mbrijbhushan/HV-amplifier/README.md

# HV-amplifier
High-Voltage amplifier design files (+/- 415V, 10 mA current limit, 400 kHz bandwidth)
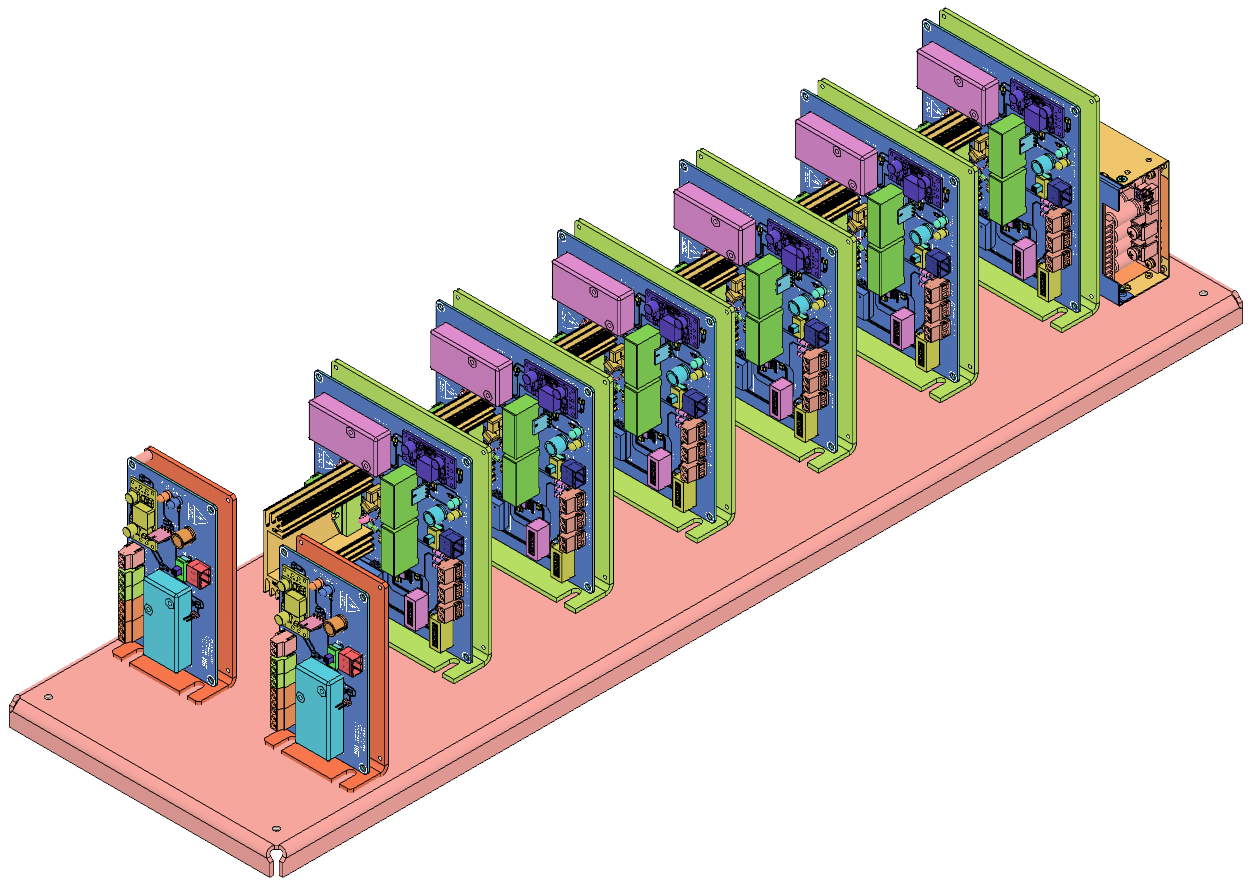
[picture p1: PCB_mounting/Amplifer__PCB_mount v39.png]
Amplifiers mounted on PCB mounts
