mbrijbhushan/HV-amplifier/HV_amplifier/CAD.png

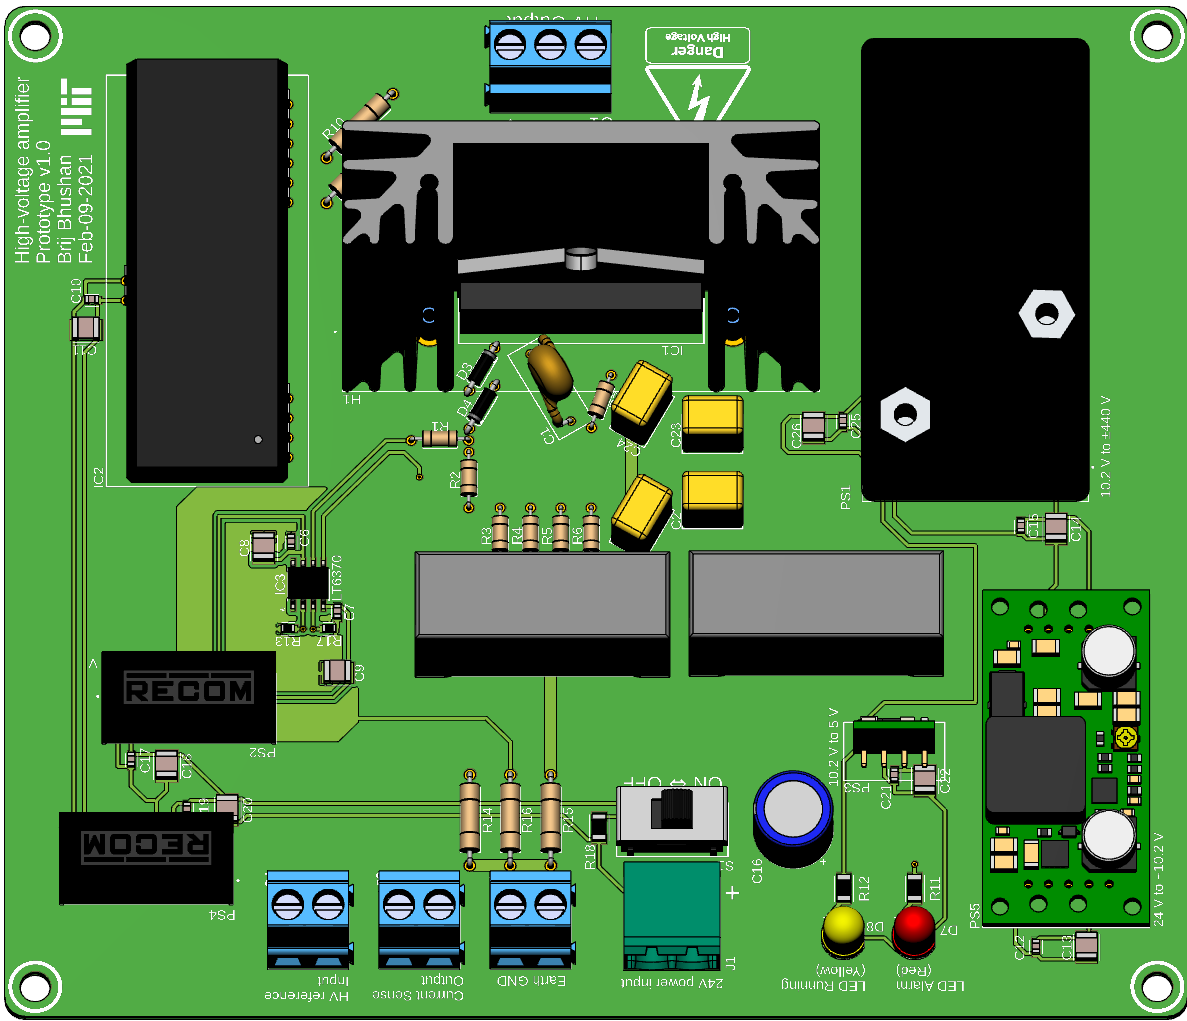
HV_amplifier/CAD.png
