mbrijbhushan/HV-amplifier/HV_powerSupply/CAD.png

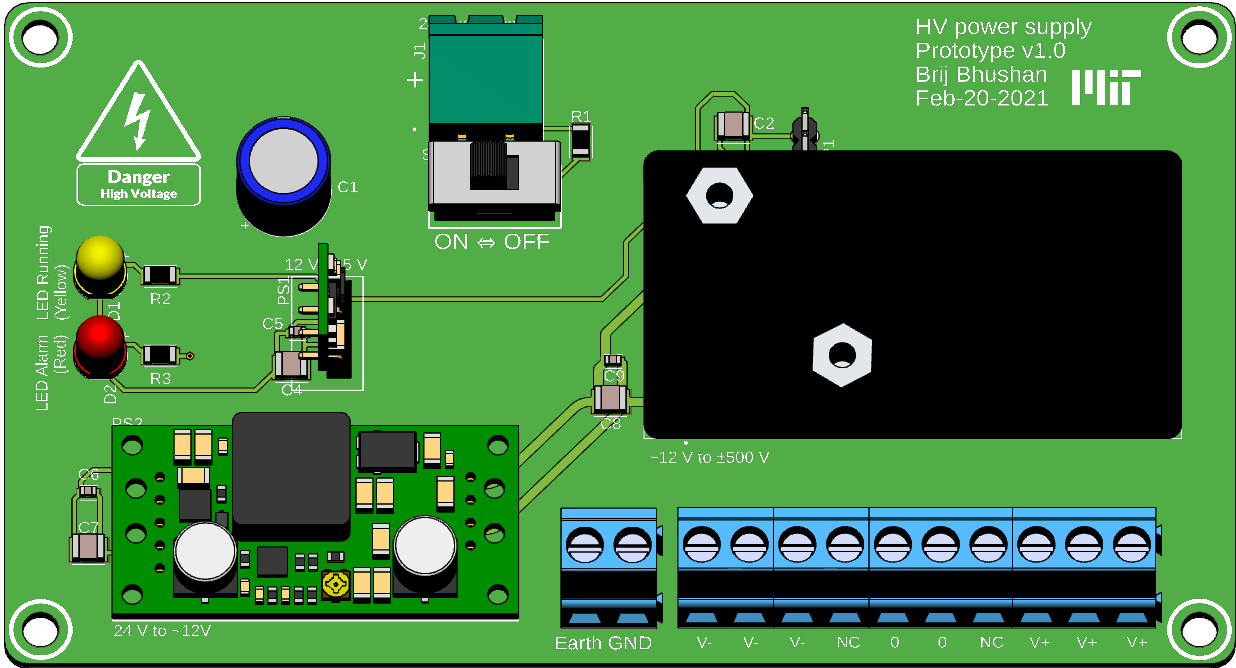
HV_powerSupply/CAD.png
