mbrijbhushan/HV-amplifier/BOM_list.xlsx

Sheet: Lin Amplifer (±440V)
#boards | 6 |  | $507.5366667 | (per ch.) |  | $3045.22 | (total)
Sch. Name | Part Number | Make | Cost per unit | # units per board | total # of units | Total cost | Vendor | Description
- | CUS600M-24/EF | TDK-Lambda | $190.00 | - | 1 | $190 | Digi-Key (https://www.digikey.com/product-detail/en/CUS600M-24%2fEF/285-CUS600M-24%2fEF-ND/12749522/?itemSeq=351333277) | 110VAC to 24VDC converter
C1 | 9004D7 | NTE Electronics, Inc | $0.20 | 1 | 6 | $1.2 | Digi-Key (https://www.digikey.com/product-detail/en/nte-electronics-inc/9004D7/2368-9004D7-ND/11648790) | Capacitor ceramic, 4.7pF, 1kV, radial, thru hole
C14 | CL32B226KAJNNNE | Samsung Electro-Mechanics | $0.60 | 1 | 6 | $3.6 | Digi-Key (https://www.digikey.com/en/products/detail/samsung-electro-mechanics/CL32B226KAJNNNE/3891478) | 22µF ±10% 25V Ceramic Capacitor X7R 1210 (3225 Metric)
C16 | A759MX447M1HAAE028 | Kemet | $3.00 | 2 | 12 | $36 | Digi-Key (https://www.digikey.com/en/products/detail/kemet/A759MX447M1HAAE028/6196518) | 440µF 50V Aluminum - Polymer Capacitors Radial, Can 28mOhm 2000 Hrs @ 125°C
C2 - C3 | C330C104KDR5TA | Kemet | $0.60 | 2 | 12 | $7.2 | Digi-Key (https://www.digikey.com/product-detail/en/kemet/C330C104KDR5TA/399-11994-ND/5267747) | Capacitor ceramic, 0.1uF, 1kV, X7R, radial, thru hole
C23 - C24 | CK45-B3AD102KYVNA | TDK Corporation | $0.40 | 2 | 12 | $4.8 | Digi-Key (https://www.digikey.com/en/products/detail/tdk-corporation/CK45-B3AD102KYVNA/8119816) | 1000pF ±10% 1000V (1kV) Ceramic Capacitor B Radial, Disc
C4 - C5 | C4AQSBU4100A1WJ | KEMET | $1.50 | 2 | 12 | $18 | Digi-Key (https://www.digikey.com/en/products/detail/kemet/C4AQSBU4100A1WJ/8345907) | 1µF Film Capacitor 1500V (1.5kV) Polypropylene (PP), Metallized Radial
C6,C7,C10,C12,C15,C17,C19,C21,C25 | CL10B104KB8NNWC | Samsung Electromechanics | $0.09 | 10 | 60 | $5.4 | Digi-Key (https://www.digikey.com/en/products/detail/samsung-electro-mechanics/CL10B104KB8NNWC/3890021) | 0.1µF ±10% 50V Ceramic Capacitor X7R 0603 (1608 Metric)
C8,C9,C11,C13,C18,C20,C22,C26 | CL32B106KBJNNNE | Samsung Electromechanics | $0.51 | 10 | 60 | $30.6 | Digi-Key (https://www.digikey.com/en/products/detail/samsung-electro-mechanics/CL32B106KBJNNNE/3891473) | 10µF ±10% 50V Ceramic Capacitor X7R 1210 (3225 Metric)
D1 - D2 | P6KE440A | Littlefuse Inc | $0.50 | 2 | 12 | $6 | Digi-Key (https://www.digikey.com/product-detail/en/littelfuse-inc/P6KE440A/P6KE440ALFCT-ND/1530656) | Transient Voltage Supression (Zener) diode, protect PA-95 power supplies from transients
D3 - D4 | 1N4148TR | Vishay | $0.06 | 2 | 12 | $0.72 | Digi-Key (https://www.digikey.com/product-detail/en/vishay-general-semiconductor-diodes-division/1N4148TR/1N4148VSCT-ND/3104297) | Small Signal Fast Switching Diodes, 4 ns recovery
D5 - D6 | NTE575 | NTE Electronics, Inc | $0.70 | 2 | 12 | $8.4 | Digi-Key (https://www.digikey.com/en/products/detail/nte-electronics-inc/NTE575/11647476) | Diode Standard 1000V 1A Through Hole DO-41
D7 | SSL-LX5093SID | Lumex Opto/Components Inc. | $0.50 | 1 | 6 | $3 | Digi-Key (https://www.digikey.com/en/products/detail/lumex-opto-components-inc/SSL-LX5093SID/519349) | Red LED Indication - Discrete 2V Radial
D8 | XLMYK65D | SunLED | $0.40 | 1 | 6 | $2.4 | Digi-Key (https://www.digikey.com/en/products/detail/sunled/XLMYK65D/13559343) | Yellow 590nm LED Indication - Discrete 2V Radial
IC3 | LT6370AHS8E#PBF | Analog Devices | $7.50 | 1 | 6 | $45 | Digi-Key (https://www.digikey.com/product-detail/en/analog-devices-inc/LT6370AHS8E-PBF/161-LT6370AHS8E-PBF-ND/10816302) | Instrumentation amplifier, used with G = -1
J1 | TBP01R1-508-02BE | CUI Devices | $0.50 | 1 | 6 | $3 | Digi-Key (https://www.digikey.com/en/products/detail/cui-devices/TBP01R1-508-02BE/10238383) | 2 Position Terminal Block Header, Male Pins, Shrouded (4 Side) 0.200" (5.08mm) 90°, Right Angle Through Hole
JG1 | TBP01P1-508-02BE | CUI Devices | $0.70 | 1 | 6 | $4.2 | Digi-Key (https://www.digikey.com/en/products/detail/cui-devices/TBP01P1-508-02BE/10238367) | 2 Position Terminal Block Plug, Female Sockets 0.200" (5.08mm) 180° Free Hanging (In-Line)
PS1 | FS10CT-12 | XP Power | $165.00 | 1 | 6 | $990 | Digi-Key (https://www.digikey.com/product-detail/en/FS10CT-12/1470-3291-ND/5873591/?itemSeq=351345335) | 12V DC to +/- 500 V DC converter
PS2 | RS-2415D | Recom Power | $14.00 | 1 | 6 | $84 | Digi-Key (https://www.digikey.com/product-detail/en/recom-power/RS-2415D/945-1316-ND/2256496) | 24 V to +/- 15 V DC-DC converter
PS4 | RS-2415S | Recom Power | $13.00 | 1 | 6 | $78 | Digi-Key (https://www.digikey.com/product-detail/en/recom-power/RS-2415S/945-1317-ND/2256497) | 24 V to 15 V DC-DC converter
R1 | MFP-25BRD52-12K | Yageo | $0.40 | 1 | 6 | $2.4 | Digi-Key (https://www.digikey.com/product-detail/en/yageo/MFP-25BRD52-12K/12KADCT-ND/2059116) | Resistor 12Kohm, 1/4W, 0.1% axial, Thru hole
R10 | CMF601K0000BHEB | Vishay Dale | $0.70 | 1 | 6 | $4.2 | Digi-Key (https://www.digikey.com/en/products/detail/vishay-dale/CMF601K0000BHEB/11561885) | 1 kOhms ±0.1% 1W Through Hole Resistor Axial Flame Retardant Coating, Moisture Resistant, Safety Metal Film
R11, R12 | RMCF1206JT240R | Stackpole Electronics Inc | $0.10 | 2 | 12 | $1.2 | Digi-Key (https://www.digikey.com/en/products/detail/stackpole-electronics-inc/RMCF1206JT240R/1942774) | 240 Ohms ±5% 0.25W, 1/4W Chip Resistor 1206 (3216 Metric) Automotive AEC-Q200 Thick Film
R13,R17 | ERA-3AEB104V | Panasonic Electronic Components | $0.30 | 2 | 12 | $3.6 | Digi-Key (https://www.digikey.com/en/products/detail/panasonic-electronic-components/ERA-3AEB104V/1466100) | 100 kOhms ±0.1% 0.1W, 1/10W Chip Resistor 0603 (1608 Metric) Automotive AEC-Q200 Thin Film
R14-R16 | ZR0207C | TE Connectivity Passive Product | $0.09 | 3 | 18 | $1.62 | Digi-Key (https://www.digikey.com/en/products/detail/te-connectivity-passive-product/ZR0207C/3477589) | 0 Ohms Jumper 0.25W, 1/4W Through Hole Resistor Axial Metal Foil
R18 | RPC1206JT1K00-UP | Stackpole Elec. Inc | $0.23 | 1 | 6 | $1.38 | Digi-Key (https://www.digikey.com/en/products/detail/stackpole-electronics-inc/RPC1206JT1K00-UP/10109084) | 1 kOhms ±5% 0.75W, 3/4W Chip Resistor 1206 (3216 Metric) Automotive AEC-Q200, Pulse Withstanding Thick Film
R19-R22 | ERT-J1VT202J | Panasonic Electronic Components | $0.15 | 4 | 24 | $3.6 | Digi-Key (https://www.digikey.com/en/products/detail/panasonic-electronic-components/ERT-J1VT202J/269345) | NTC Thermistor 2k 0603 (1608 Metric)
R2 - R6 | RNF14BTE100K | Stackpole Elec. Inc | $0.40 | 5 | 30 | $12 | Digi-Key (https://www.digikey.com/product-detail/en/stackpole-electronics-inc/RNF14BTE100K/RNF14BTE100KCT-ND/2022685) | Resistor 100Kohm, 1/4W, 0.1% axial, Thru hole
R7 | MFP-25BRD52-33R | Yageo | $0.40 | 1 | 6 | $2.4 | Digi-Key (https://www.digikey.com/product-detail/en/yageo/MFP-25BRD52-33R/33ADCT-ND/2059133) | Resistor 33ohm, 1/4W, 0.1% axial, Thru hole
R7* | MFP-25BRD52-75R | Yageo | $0.60 | 1 | 6 | $3.6 | Digi-Key (https://www.digikey.com/en/products/detail/yageo/MFP-25BRD52-75R/2059147) | 75 Ohms ±0.1% 0.25W, 1/4W Through Hole Resistor Axial Metal Film
R8 | CMF60100R00BHEB70 | Vishay Dale | $0.60 | 1 | 6 | $3.6 | Digi-Key (https://www.digikey.com/product-detail/en/vishay-dale/CMF60100R00BHEB70/541-CMF60100R00BHEB70CT-ND/11561982) | Resistor 100ohm, 1W, 0.1% axial, Thru hole
R9 | CMF559K0000BHBF | Vishay Dale | $0.70 | 1 | 6 | $4.2 | Digi-Key (https://www.digikey.com/en/products/detail/vishay-dale/CMF559K0000BHBF/3634478) | 9 kOhms ±0.1% 0.5W, 1/2W Through Hole Resistor Axial Flame Retardant Coating, Moisture Resistant, Safety Metal Film
S1 | CS12ANW03 | NKK Switches | $2.00 | 1 | 6 | $12 | Digi-Key (https://www.digikey.com/product-detail/en/nkk-switches/CS12ANW03/360-2131-ND/1014827) | SPDT slider switch for on/off
U1 | TB007-508-03BE | CUI Devices | $0.70 | 1 | 6 | $4.2 | Digi-Key (https://www.digikey.com/en/products/detail/cui-devices/TB007-508-03BE/10064128) | 3 Position Wire to Board Terminal Block Horizontal with Board 0.200" (5.08mm) Through Hole
U2-U4 | TB007-508-02BE | CUI Devices | $0.65 | 3 | 18 | $11.7 | Digi-Key (https://www.digikey.com/product-detail/en/cui-devices/TB007-508-02BE/102-6203-ND/10064127) | 2 Position Wire to Board Terminal Block Horizontal with Board 0.200" (5.08mm) Through Hole
PS3 | D24V5F5 | Pololu | $5.00 | 1 | 6 | $30 | Pololu (https://www.pololu.com/product/2843) | 5V, 500 mA step-down voltage regulator
PS5 | S18V20ALV | Pololu | $15.00 | 1 | 6 | $90 | Pololu (https://www.pololu.com/product/2572) | 4-12V step-up/step-down voltage regulator
H1 | HS 27 | Apex | $35.00 | 1 | 6 | $210 | TTL Electronics (https://ttlelectronics.net/shop/ols/products/hs27/v/HS27-1-9) | Heat-sink for linear power amplifiers
IC1 | PA 95 | Apex | $147.00 | 1 | 6 | $882 | TTL Electronics (https://ttlelectronics.net/shop/ols/products/pa95) | HV Linear power amplifiers
W1 | TW 13 | Apex | $10.00 | 1 | 6 | $60 | TTL Electronics (https://ttlelectronics.net/shop/ols/products/tw13) | Thermal Washer, SIP, 10 per pkg (for PA95)
IC2 | AD210BN | Analog Devices | $30.00 | 1 | 6 | $180 | UtSource (https://www.utsource.net/itm/p/1701914.html) | Isolation amplifier to sense the current
 |  |  |  |  |  | $0
 |  |  |  |  |  | $0

Sheet: Const. Volt (±440V)
#boards | 2 |  | $205.85 | (per ch.) | $411.7 | (total)
Sch. Name | Part Number | Make | Cost per unit | # units per board | total # of units | Total cost | Vendor | Description
- | CUS600M-24/EF | TDK-Lambda | $190.00 | 0 | 0 | $0 | Digi-Key (https://www.digikey.com/product-detail/en/CUS600M-24%2fEF/285-CUS600M-24%2fEF-ND/12749522/?itemSeq=351333277) | 110VAC to 24VDC convertor
C1 | A759MX447M1HAAE028 | Kemet | $3.00 | 2 | 4 | $12 | Digi-Key (https://www.digikey.com/en/products/detail/kemet/A759MX447M1HAAE028/6196518) | 440µF 50V Aluminum - Polymer Capacitors Radial, Can 28mOhm 2000 Hrs @ 125°C
C2,C4,C7 | CL32B106KBJNNNE | Samsung Electromechanics | $0.51 | 10 | 20 | $10.2 | Digi-Key (https://www.digikey.com/en/products/detail/samsung-electro-mechanics/CL32B106KBJNNNE/3891473) | 10µF ±10% 50V Ceramic Capacitor X7R 1210 (3225 Metric)
C3,C5,C6,C9 | CL10B104KB8NNWC | Samsung Electromechanics | $0.09 | 10 | 20 | $1.8 | Digi-Key (https://www.digikey.com/en/products/detail/samsung-electro-mechanics/CL10B104KB8NNWC/3890021) | 0.1µF ±10% 50V Ceramic Capacitor X7R 0603 (1608 Metric)
C8 | CL32B226KAJNNNE | Samsung Electro-Mechanics | $0.60 | 1 | 2 | $1.2 | Digi-Key (https://www.digikey.com/en/products/detail/samsung-electro-mechanics/CL32B226KAJNNNE/3891478) | 22µF ±10% 25V Ceramic Capacitor X7R 1210 (3225 Metric)
D1 | XLMYK65D | SunLED | $0.40 | 1 | 2 | $0.8 | Digi-Key (https://www.digikey.com/en/products/detail/sunled/XLMYK65D/13559343) | Yellow 590nm LED Indication - Discrete 2V Radial
D2 | SSL-LX5093SID | Lumex Opto/Components Inc. | $0.50 | 1 | 2 | $1 | Digi-Key (https://www.digikey.com/en/products/detail/lumex-opto-components-inc/SSL-LX5093SID/519349) | Red LED Indication - Discrete 2V Radial
J1 | TBP01R1-508-02BE | CUI Devices | $0.50 | 1 | 2 | $1 | Digi-Key (https://www.digikey.com/en/products/detail/cui-devices/TBP01R1-508-02BE/10238383) | 2 Position Terminal Block Header, Male Pins, Shrouded (4 Side) 0.200" (5.08mm) 90°, Right Angle Through Hole
JG1 | TBP01P1-508-02BE | CUI Devices | $0.70 | 1 | 2 | $1.4 | Digi-Key (https://www.digikey.com/en/products/detail/cui-devices/TBP01P1-508-02BE/10238367) | 2 Position Terminal Block Plug, Female Sockets 0.200" (5.08mm) 180° Free Hanging (In-Line)
JP1 | PREC002SAAN-RC | Sullins Connector Solutions | $0.50 | 1 | 2 | $1 | Digi-Key (https://www.digikey.com/en/products/detail/sullins-connector-solutions/PREC002SAAN-RC/2774852) | Connector Header Through Hole 2 position 0.100" (2.54mm)
JPC1 | SPC02SYAN | Sullins Connector Solutions | $0.50 | 1 | 2 | $1 | Digi-Key (https://www.digikey.com/en/products/detail/sullins-connector-solutions/SPC02SYAN/76375) | 2 (1 x 2) Position Shunt Connector Black Closed Top 0.100" (2.54mm) Gold
PS3 | FS10CT-12 | XP Power | $165.00 | 1 | 2 | $330 | Digi-Key (https://www.digikey.com/product-detail/en/FS10CT-12/1470-3291-ND/5873591) | 12V DC to +/- 500 V DC convertor
R1 | RPC1206JT1K00-UP | Stackpole Elec. Inc | $0.30 | 1 | 2 | $0.6 | Digi-Key (https://www.digikey.com/en/products/detail/stackpole-electronics-inc/RPC1206JT1K00-UP/10109084) | 1 kOhms ±5% 0.75W, 3/4W Chip Resistor 1206 (3216 Metric) Automotive AEC-Q200, Pulse Withstanding Thick Film
R2,R3 | RMCF1206JT240R | Stackpole Electronics Inc | $0.10 | 2 | 4 | $0.4 | Digi-Key (https://www.digikey.com/en/products/detail/stackpole-electronics-inc/RMCF1206JT240R/1942774) | 240 Ohms ±5% 0.25W, 1/4W Chip Resistor 1206 (3216 Metric) Automotive AEC-Q200 Thick Film
S1 | CS12ANW03 | NKK Switches | $2.00 | 1 | 2 | $4 | Digi-Key (https://www.digikey.com/product-detail/en/nkk-switches/CS12ANW03/360-2131-ND/1014827) | SPDT slider switch for on/off
U1 | TB007-508-02BE | CUI Devices | $0.65 | 1 | 2 | $1.3 | Digi-Key (https://www.digikey.com/product-detail/en/cui-devices/TB007-508-02BE/102-6203-ND/10064127) | 2 Position Wire to Board Terminal Block Horizontal with Board 0.200" (5.08mm) Through Hole
U2 | TB007-508-10BE | CUI Devices | $2.00 | 1 | 2 | $4 | Digi-Key (https://www.digikey.com/en/products/detail/cui-devices/TB007-508-10BE/10064134) | 10 Position Wire to Board Terminal Block Horizontal with Board 0.200" (5.08mm) Through Hole
PS1 | D24V5F5 | Pololu | $5.00 | 1 | 2 | $10 | Pololu (https://www.pololu.com/product/2843) | 5V, 500 mA step-down voltage regulator
PS2 | S18V20ALV | Pololu | $15.00 | 1 | 2 | $30 | Pololu (https://www.pololu.com/product/2572) | 4-12V step-up/step-down voltage regulator
 |  |  |  |  | 0 | $0

Sheet: Cables
#boards | 8 |  | $134.875 | (per ch.) |  | $1079 | (total)
Sch. Name | Part Number | Make | Cost per unit | # units per board | total # of units | Total cost | Vendor | Description
- | CUS600M-24/EF | TDK-Lambda | $190.00 | - | 1 | $190 | Digi-Key (https://www.digikey.com/product-detail/en/CUS600M-24%2fEF/285-CUS600M-24%2fEF-ND/12749522/?itemSeq=351333277) | 110VAC to 24VDC converter
BE-M | 1709 SL005 | Alpha Wire | $2.50 |  | 100 | $250 | Digi-Key (https://www.digikey.com/en/products/detail/alpha-wire/1709-SL005/3702575) | Electrode HV cable (main electrodes) |2 Conductor Microphone Cable Slate 24 AWG Spiral 100.0' (30.5m), 1000 V
BE-R | 2170297 | LAPP | $1.50 | - | 50 | $75 | Digi-Key (https://www.digikey.com/en/products/detail/lapp/2170297/12147937) | Electrode HV cable (ring electrodes) | 8 (4 Pair Twisted) Conductor Multi-Pair, Cat5e Cable Teal 24 AWG Foil, Braid, 1000 V
BE-R* | 2170281 | LAPP | $1.25 | - | 50 | $62.5 | Digi-Key (https://www.digikey.com/en/products/detail/lapp/2170281/12148475) | Electrode HV cable (ring electrodes) | 4 (2 Pair Twisted) Conductor Multi-Pair, Cat5e Cable Teal 24 AWG Foil, Braid 1000 V
BP | CF891-05-02 | Igus | $0.75 | - | 50 | $37.5 | Digi-Key (https://www.digikey.com/en/products/detail/igus/CF891-05-02/12179300) | 24V Power cable (to each board) | 2 (1 Pair Twisted) Conductor Multi-Conductor Cable Black 20 AWG Braid , 600 V
BS | CF891-05-02 | Igus | $0.75 | - | 100 | $75 | Digi-Key (https://www.digikey.com/en/products/detail/igus/CF891-05-02/12179300) | Signal cable (HV reference, Current sense) | 2 (1 Pair Twisted) Conductor Multi-Conductor Cable Black 20 AWG Braid, 600 V
BS* | 44A1121-24-0/9-9-MX | TE Connectivity | $1.00 | - | 100 | $100 | Digi-Key (https://www.digikey.com/en/products/detail/te-connectivity-aerospace-defense-and-marine/44A1121-24-0-9-9-MX/6058779) | Signal cable (HV reference, Current sense) | 2 Conductor Multi-Conductor Cable White 24 AWG Braid, 600 V
BTB | 25-B500-08 | NTE Electronics, Inc | $4.00 | - | 6 | $24 | Digi-Key (https://www.digikey.com/en/products/detail/nte-electronics-inc/25-B500-08/11653434) | for 24 V supply (2 wires/board), for eddy sensor power supply |8 Circuit 0.374" (9.50mm) Barrier Block Connector, Screws with Captive Plate
BTB* | 387600308 | Molex | $4.00 | - | 6 | $24 | Digi-Key (https://www.digikey.com/en/products/detail/0387600308/WM13936-ND/3300995) | for 24 V supply (2 wires/board), for eddy sensor power supply |8 Circuit 0.374" (9.50mm) Barrier Block Connector, Screws with Captive Plate
BTBS | 380021290 | Molex | $2.50 | - | 3 | $7.5 | Digi-Key (https://www.digikey.com/en/products/detail/molex/0380021290/604531) | to short all pins of one side | 8 Position Barrier Block Jumper Around Barrier, Flanged Spade
ETS | HE4HNWPR/12 | Altech Corporation | $4.50 | - | 3 | $13.5 | Digi-Key (https://www.digikey.com/en/products/detail/altech-corporation/HE4HNWPR-12/8547167) | for electrodes | 12 Circuit 0.394" (10.00mm) Eurostyle Terminal Strip Connector, Screws
RACK | RA-24CP | Fancort Industries, Inc. | $40.00 | - | 3 | $120 | Fancort Industries (https://fancort.com/collections/pcb-racks/products/model-ra-24) | Rack to hold PCBs | 20 Slots with easy-to-load angle (.125” W x .325” D on a 1” pitch), Measures 8.375” x 23”
RACK* | ‎C3RWT836‎ | Hammond Manufacturing | $100.00 | - | 1 | $100 | Digi-Key (https://www.digikey.com/en/products/detail/hammond-manufacturing/C3RWT836/3870294) | Box Metal, Steel Gray Cover Included 36.000" L x 8.000" W (914.40mm x 203.20mm) X 8.000" (203.20mm)

Sheet: Anti-alias filter
#boards | 20 |  | $4.56 | (per ch.) |  | $91.2 | (total)
Sch. Name | Part Number | Make | Cost per unit | # units per board | total # of units | Total cost | Vendor | Description
R | ERA-3AEB104V | Panasonic Electronic Components | $0.30 | 2 | 40 | $12 | Digi-Key (https://www.digikey.com/en/products/detail/panasonic-electronic-components/ERA-3AEB104V/1466100) | 100 kOhms ±0.1% 0.1W, 1/10W Chip Resistor 0603 (1608 Metric) Automotive AEC-Q200 Thin Film
C | CL10C151JB8NFNC | Samsung Electro-Mechanics | $0.10 | 1 | 20 | $2 | Digi-Key (https://www.digikey.com/en/products/detail/samsung-electro-mechanics/CL10C151JB8NFNC/3887858) | 150pF ±5% 50V Ceramic Capacitor C0G, NP0 0603 (1608 Metric)
R* | CMF55100K00BHEB | Vishay Dale | $0.80 | 2 | 40 | $32 | Digi-Key (https://www.digikey.com/en/products/detail/vishay-dale/CMF55100K00BHEB/3622080) | 100 kOhms ±0.1% 0.5W, 1/2W Through Hole Resistor Axial Flame Retardant Coating, Moisture Resistant, Safety Metal Film
C* | FG18C0G1H151JNT00 | TDK Corporation | $0.10 | 1 | 20 | $2 | Digi-Key (https://www.digikey.com/en/products/detail/tdk-corporation/FG18C0G1H151JNT00/7326694) | 150pF ±5% 50V Ceramic Capacitor C0G, NP0 Radial
BRD | SBBTH1506-1 | Chip Quik Inc. | $1.00 | 1 | 20 | $20 | Digi-Key (https://www.digikey.com/en/products/detail/chip-quik-inc/SBBTH1506-1/5978222) | Breadboard, General Purpose Plated Through Hole (PTH) Pad Per Hole (Round)
HDR-M | PRPC002SAAN-RC | Sullins Connector Solutions | $0.08 | 2 | 40 | $3.2 | Digi-Key (https://www.digikey.com/en/products/detail/sullins-connector-solutions/PRPC002SAAN-RC/2775252) | Connector Header Through Hole 2 position 0.100" (2.54mm)
HDR-F | PPPC021LFBN-RC | Sullins Connector Solutions | $0.50 | 2 | 40 | $20 | Digi-Key (https://www.digikey.com/en/products/detail/sullins-connector-solutions/PPPC021LFBN-RC/810174) | 2 Position Header Connector 0.100" (2.54mm) Through Hole Gold
 |  |  |  |  | 0 | $0
 |  |  |  |  | 0 | $0
 |  |  |  |  | 0 | $0
 |  |  |  |  | 0 | $0
