mbrijbhushan/HV-amplifier/HV_amplifier/schematic.pdf

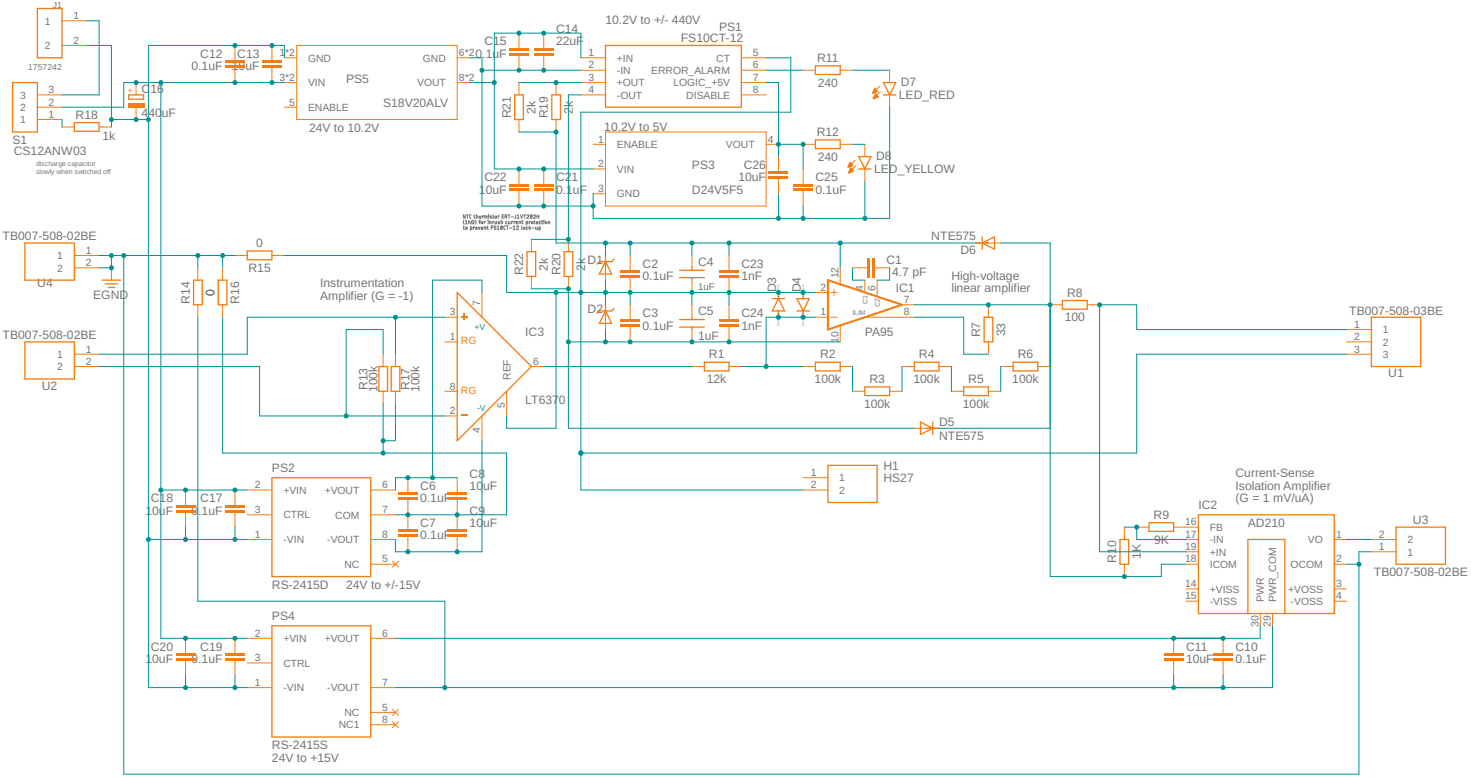
[picture p4: page 1]

SpiceOrder 1 SpiceOrder 2 SpiceOrder 1 SpiceOrder 2 24V to +15V 24V to +/-15V Instrumentation Amplifier (G = -1) 24V to 10.2V 10.2V to +/- 440V 10.2V to 5V High-voltage linear amplifier Current-Sense Isolation Amplifier (G = 1 mV/uA) discharge capacitor slowly when swtiched off PA95HS27 4.7 pF FS10CT-12 1757242 0.1uF 0.1uF 1uF 1uF NTE575 NTE575 S18V20ALV AD210 LT6370 RS-2415D RS-2415S 0.1uF 0.1uF 10uF 10uF 10uF 0.1uF 0.1uF 10uF 22uF 0.1uF 440uF 10uF 0.1uF 10uF 0.1uF 10uF 0.1uF D24V5F5 LED_RED LED_YELLOW EGND CS12ANW03 1nF 1nF 0.1uF 10uF IC1 ILIM C1 C2 12 7 12 10 8 46 H1 1 1 2 2 R1 12k R2 100k R3 100k R4 100k R5 100k R6 100k R733 C1 R8 100 PS1 +IN 1 -IN 2 +OUT 3 -OUT 4 CT 5 ERROR_ALARM 6 LOGIC_+5V 7 DISABLE 8 J1 1 1 2 2 C2 C3 C4 C5 D1 D2 D3 D4 D5 D6 U1 TB007-508-03BE 1 1 2 2 3 3 PS5 GND 1*2 VIN 3*2 ENABLE 5 GND 6*2 VOUT 8*2 IC2 VO 1 OCOM 2 +VOSS 3 -VOSS 4 +VISS 14 -VISS 15 FB 16 -IN 17 ICOM 18 +IN 19 PWR_COM 29 PWR 30 IC3 32 4 7 6 18 REF 5 U2 TB007-508-02BE 1 1 2 2 U3 TB007-508-02BE 1 1 2 2 R99K R10 1K PS2+VIN 2 +VOUT 6 -VOUT 8 -VIN 1 CTRL 3 COM 7 NC 5 PS4+VIN 2 +VOUT 6 -VOUT 7 -VIN 1 CTRL 3 NC1 8 NC 5 C6 C7 C8 C9 C11 C10 C12 C13 C14 C15 C16C18 C17 C20 C19 PS3 GND 3 VIN 2 ENABLE 1 VOUT 4 C22 C21 D7 D8 R11 240 R12 240 U4 TB007-508-02BE 1 1 2 2 R140 R150 R160 S11 1 2 2 3 3 C23 C24 C25 C26 R13 100k R17 100k R18 1k R19 2k R20 2k R21 2k R22 2k RGRG + HV amplifier board v71 not saved! Sheet: 1/1 ABCDE 1 2 3 4 5 6 7 8 ABCDE 1 2 3 4 5 6 7 8 +V-V
