mbrijbhushan/HV-amplifier/HV_powerSupply/schematic.pdf

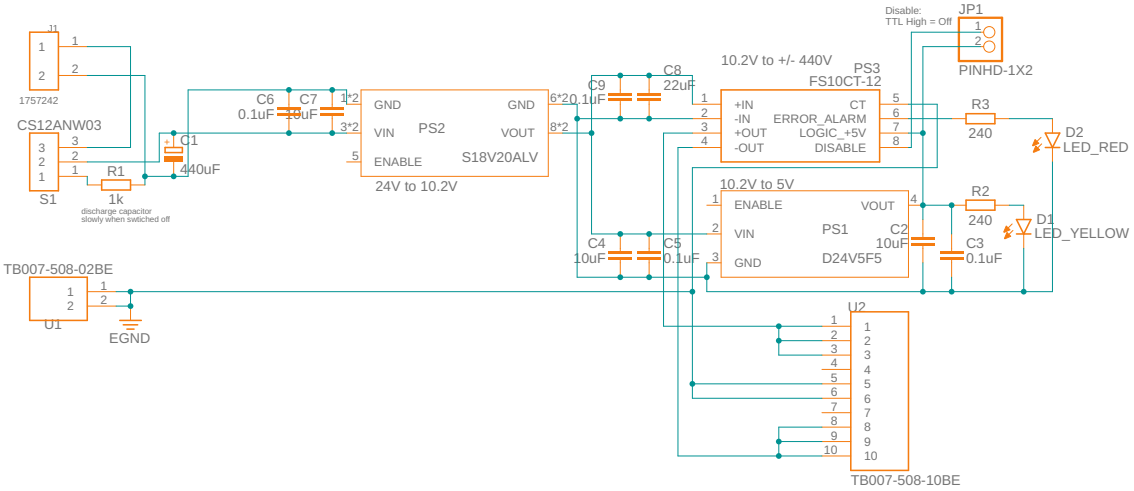
[picture p5: page 1]

Disable: TTL High = Off FS10CT-12

discharge capacitor slowly when swtiched off
