mbrijbhushan/HV-amplifier/HV_amplifier/layout_front.pdf

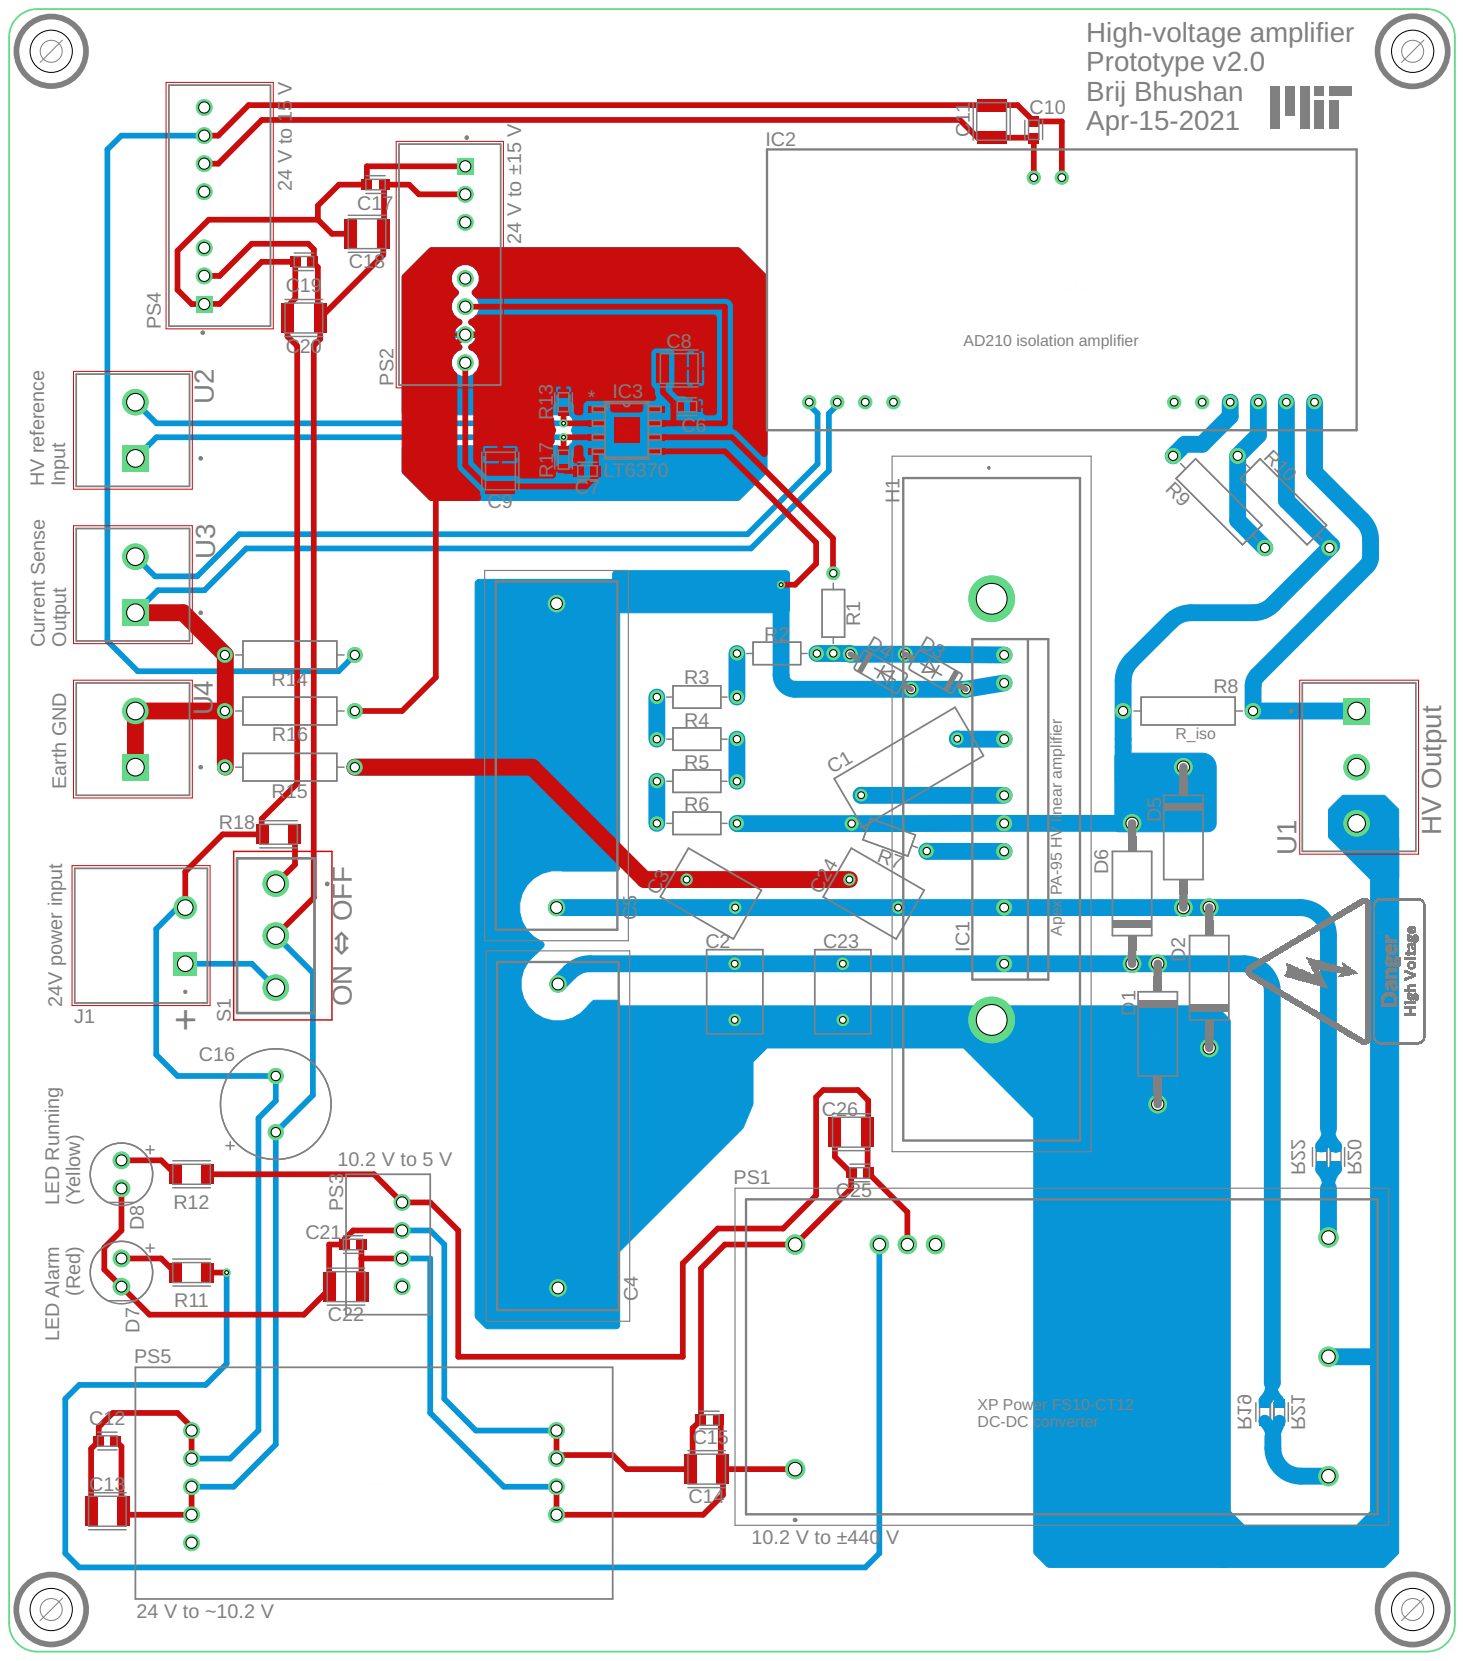
[picture p6: page 1]

R19 R20 R21 R22 * LT6370 * ON ⇔ OFF High-voltage amplifier Prototype v2.0 Brij Bhushan Apr-15-2021 24V power input Earth GND Current Sense Output HV reference Input HV Output LED Alarm (Red) LED Running (Yellow) 24 V to ~10.2 V 10.2 V to ±440 V Apex PA-95 HV linear amplifier AD210 isolation amplifier XP Power FS10-CT12 DC-DC converter R_iso + 10.2 V to 5 V 24 V to 15 V 24 V to ±15 V C1 C2 C3 C4 C5 D1 D2 D4 D3 D5 D6 H1 IC1 J1 PS1 R1 R2 R3 R4 R5 R6 R7 R8 U1 PS5 IC2 UIC3 2 U3 R9 R10 PS2 PS4 C6 C7 C8 C9 C10 C11 C12 C13 C14 C15 C16 C17 C18 C19 C20 PS3 C21C22 D7 D8 R11 R12U4R14 R15 R16 S1 C23 C24 C25 C26 R13 R17 R18
