mbrijbhushan/HV-amplifier/HV_powerSupply/layout.pdf

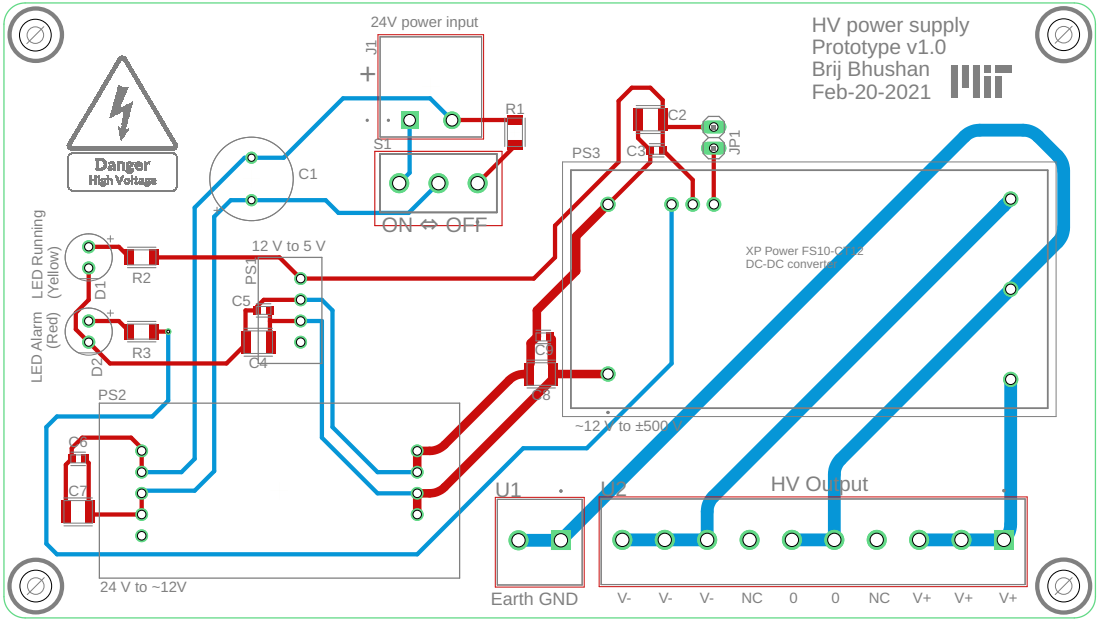
[picture p7: page 1]
