mbrijbhushan/HV-amplifier/HV_powerSupply/Eagle Files/HV_powerSupply_board_20210802.brd

## EAGLE design HV_powerSupply/Eagle Files/HV_powerSupply_board_20210802.brd (2021-08-02)

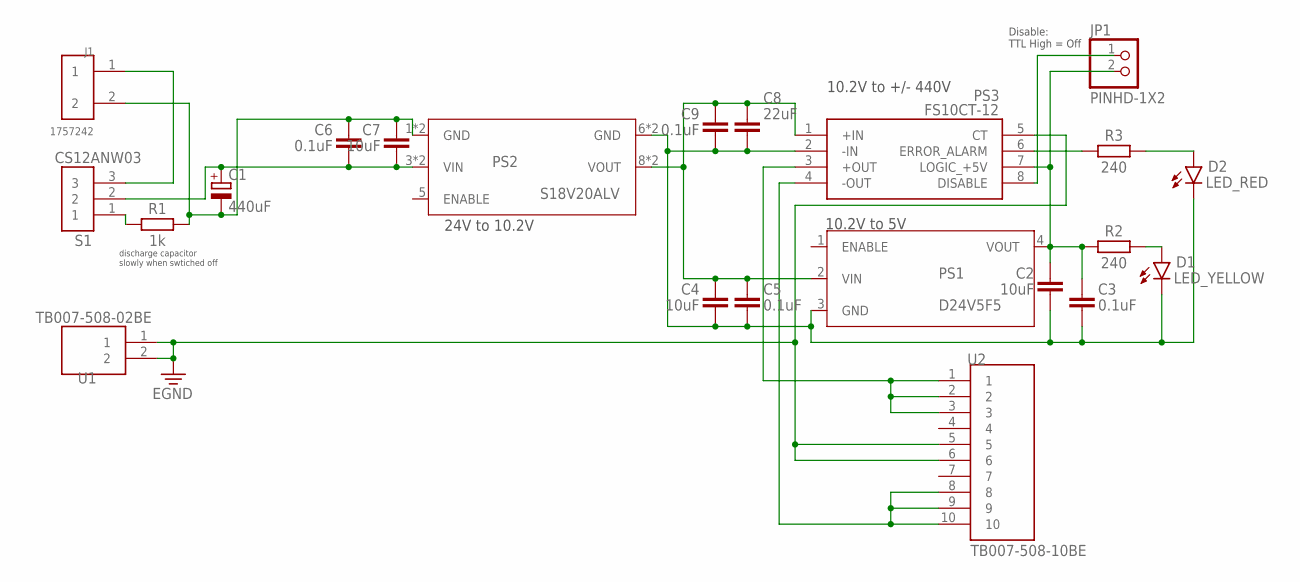
[picture p8: schematic HV_powerSupply_board_20210802.sch, High voltagepower supplies +/- 500 V using XP-power FS10-CT…]

Parts:
C1: 440uF; CAPPRD508W65D1000H1100B
C2, C4, C7: 10uF; CAPC3225X135
C3, C5, C6, C9: 0.1uF; CAPC1608X85
C8: 22uF; CAPC3225X135
D1: LED_YELLOW; LEDRD254W60D565H860B_Y
D2: LED_RED; LEDRD254W60D565H860B
J1: 1757242; PHOENIX_1757242
JP1: PINHD-1X2; 1X02
PS1: D24V5F5
PS2: S18V20ALV
PS3: FS10CT-12; FS10CT12
R1: 1k; RESC3216X70
R2, R3: 240; RESC3216X70
S1: CS12ANW03
U1: TB007-508-02BE; CUI_TB007-508-02BE
U2: TB007-508-10BE; CUI_TB007-508-10BE

Connections:
24COM: C2.2, C3.2, C4.2, C5.2, C8.2, C9.2, D1.2 (C), D2.2 (C), PS1.3 (GND), PS2.6 (GND), PS2.7 (GND), PS3.2 (-IN)
24V_COM: C1.2 (-), C6.1, C7.1, J1.2, PS2.1 (GND), PS2.2 (GND), R1.2
+5V: C2.1, C3.1, JP1.2, PS1.4 (VOUT), PS3.7 (LOGIC_+5V), R2.1
ERROR_ALARM: PS3.6 (ERROR_ALARM), R3.1
HV_COM: PS3.5 (CT), U1.1, U1.2, U2.5, U2.6
unnamed: JP1.1, PS3.8 (DISABLE)
unnamed: R1.1, S1.1
unnamed: J1.1, S1.3
unnamed: C4.1, C5.1, C8.1, C9.1, PS1.2 (VIN), PS2.8 (VOUT), PS2.9 (VOUT), PS3.1 (+IN)
unnamed: C1.1 (+), C6.2, C7.2, PS2.3 (VIN), PS2.4 (VIN), S1.2
unnamed: D2.1 (A), R3.2
unnamed: D1.1 (A), R2.2
V+: PS3.3 (+OUT), U2.1, U2.2, U2.3
V-: PS3.4 (-OUT), U2.8, U2.9, U2.10

Notes on the sheet:
24V to 10.2V
10.2V to +/- 440V
10.2V to 5V
discharge capacitor slowly when swtiched off
Disable: TTL High = Off

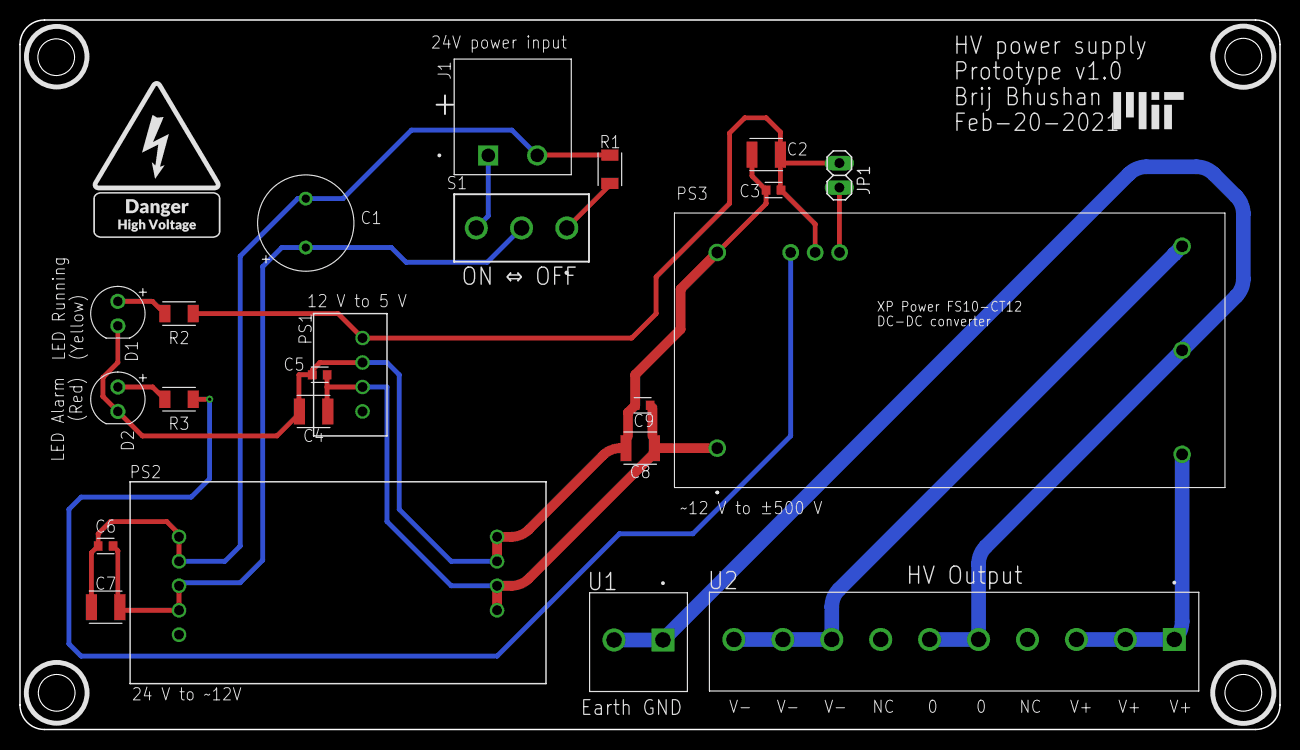
[picture p9: board HV_powerSupply_board_20210802.brd from above]

Board: 2 copper layers, 130.8 x 73.7 mm, 22 parts (0 on the bottom side), 14 nets.
