mbrijbhushan/HV-amplifier/HV_amplifier/Eagle Files/HV_amplifier_board_20210802.sch

## EAGLE design HV_amplifier/Eagle Files/HV_amplifier_board_20210802.sch (2021-08-02)

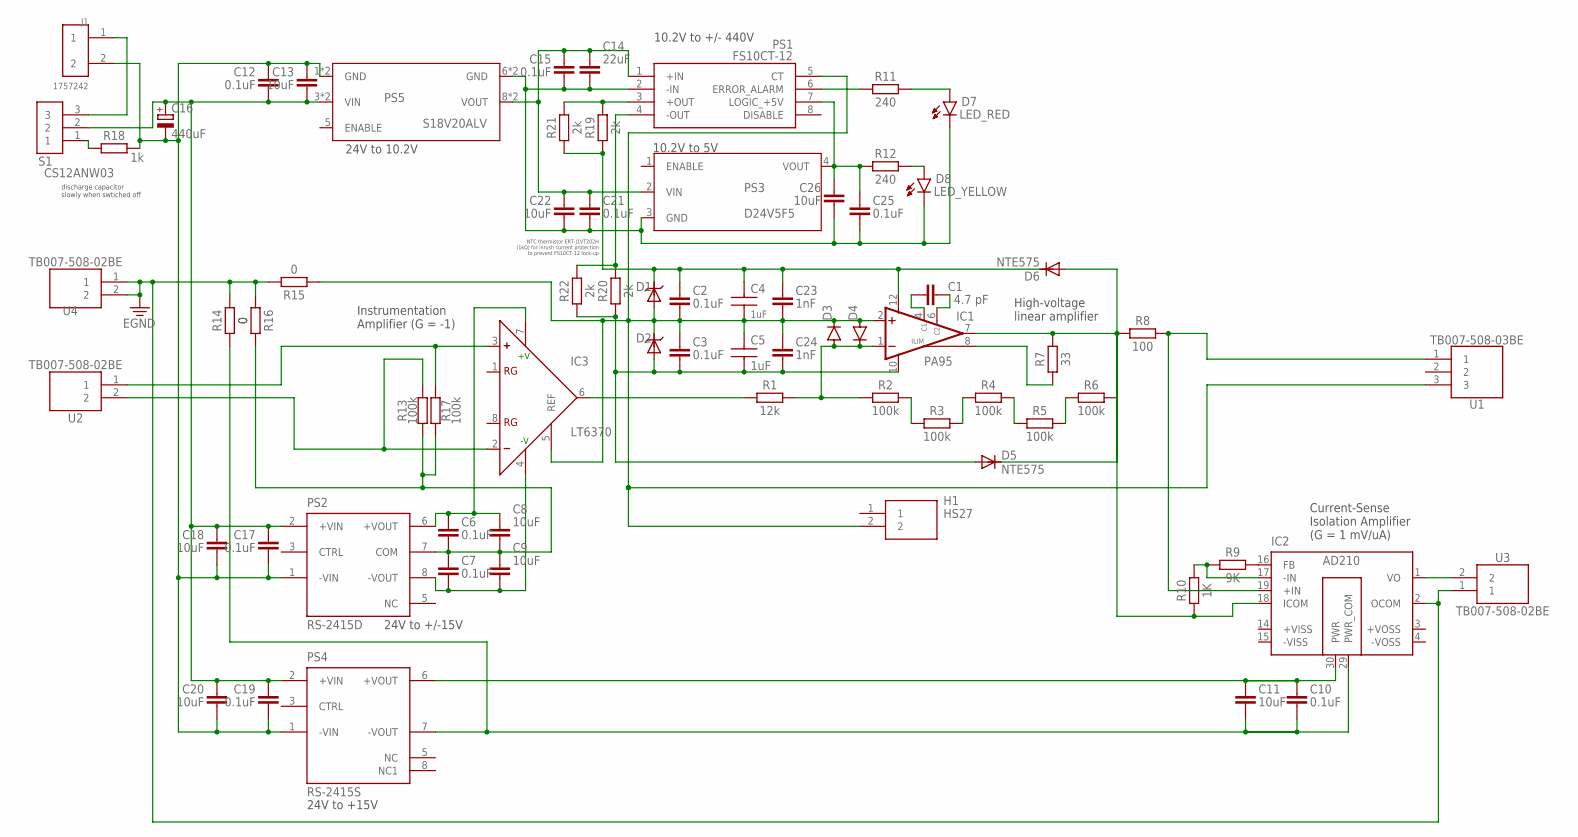
[picture p10: schematic HV_amplifier_board_20210802.sch]

Parts:
C1: 4.7 pF; C_DISC_10MM
C2, C3: 0.1uF; C_DISC_5.08MM
C4, C5: 1uF; C_FILM_27.5MM
C6, C7, C10, C12, C15, C17, C19, C21, C25: 0.1uF; CAPC1608X85
C8, C9, C11, C13, C18, C20, C22, C26: 10uF; CAPC3225X135
C14: 22uF; CAPC3225X135
C16: 440uF; CAPPRD508W65D1000H1100B
C23, C24: 1nF; C_DISC_5.08MM
D1, D2: P6KE440A; DO15-12
D3, D4: 1N4148DO35-7; DO35-7
D5, D6: NTE575; DO15-12
D7: LED_RED; LEDRD254W60D565H860B
D8: LED_YELLOW; LEDRD254W60D565H860B_Y
H1: HS27
IC1: PA95; SIP8-DQ
IC2: AD210
IC3: LT6370; SOIC_08_EP_3P9X4P9_ADI
J1: 1757242; PHOENIX_1757242
PS1: FS10CT-12; FS10CT12
PS2: RS-2415D; CONV_RS-2415D
PS3: D24V5F5
PS4: RS-2415S; CONV_RS-2415S
PS5: S18V20ALV
R1: 12k; RESAD724W46L381D178B
R2, R3, R4, R5, R6: 100k; RESAD724W46L381D178B
R7: 33; RESAD724W46L381D178B
R8: 100; RESAD1176W63L850D250B
R9: 9K; RESAD1176W63L850D250B
R10: 1K; RESAD1176W63L850D250B
R11, R12: 240; RESC3216X70
R13, R17: 100k; RESC1608X60
R14, R15, R16: 0; RESAD1176W63L850D250B
R18: 1k; RESC3216X70
R19, R20, R21, R22: 2k; RESC1608X60
S1: CS12ANW03
U1: TB007-508-03BE; CUI_TB007-508-03BE
U2, U3, U4: TB007-508-02BE; CUI_TB007-508-02BE

Connections:
24COM: C14.2, C15.2, C21.2, C22.2, C25.2, C26.2, D7.2 (C), D8.2 (C), PS1.2 (-IN), PS3.3 (GND), PS5.6 (GND)
24V_COM: C12.1, C13.1, C16.2 (-), C17.2, C18.2, C19.2, C20.2, J1.2, PS2.1 (-VIN), PS4.1 (-VIN), PS5.1 (GND), R18.2
+V: C6.1, C8.1, IC3.7 (+V), PS2.6 (+VOUT)
-V: C7.2, C9.2, IC3.4 (-V), PS2.8 (-VOUT)
COM: C6.2, C7.1, C8.2, C9.1, PS2.7 (COM), R13.1, R16.2, R17.1
HV_AMP_OUT: D5.C, D6.A, IC1.7 (OUT), IC2.18 (ICOM), R6.2, R7.2, R8.1, R10.1
HV_COM: C2.P$2 (2), C3.P$1 (1), C4.1, C5.2, C23.P$2 (2), C24.P$1 (1), D1.A, D2.C, D3.C, D4.A, H1.2, IC1.2 (+IN), IC3.5 (REF), PS1.5 (CT), R15.1, U1.3
HV_OUT: IC2.19 (+IN), R8.2, U1.1
IN-: D3.A, D4.C, IC1.1 (-IN), R1.2, R2.1
unnamed: IC2.1 (VO), U3.2
unnamed: R2.2, R3.1
unnamed: R3.2, R4.1
unnamed: R4.2, R5.1
unnamed: R5.2, R6.1
unnamed: R18.1, S1.1
unnamed: IC1.8 (ILIM), R7.1
unnamed: C1.P$1 (1), IC1.4 (C1)
unnamed: C1.P$2 (2), IC1.6 (C2)
unnamed: C25.1, C26.1, PS1.7 (LOGIC_+5V), PS3.4 (VOUT), R12.1
unnamed: J1.1, S1.3
unnamed: PS1.3 (+OUT), R19.2, R21.2
unnamed: PS1.4 (-OUT), R20.2, R22.2
unnamed: IC2.2 (OCOM), R14.2, R15.2, R16.1, U3.1, U4.1, U4.2
unnamed: C14.1, C15.1, C21.1, C22.1, PS1.1 (+IN), PS3.2 (VIN), PS5.8 (VOUT)
unnamed: C12.2, C13.2, C16.1 (+), C17.1, C18.1, C19.1, C20.1, PS2.2 (+VIN), PS4.2 (+VIN), PS5.3 (VIN), S1.2
unnamed: PS1.6 (ERROR_ALARM), R11.1
unnamed: IC3.2 (-), R13.2, U2.2
unnamed: IC3.3 (+), R17.2, U2.1
unnamed: IC2.16 (FB), R9.2
unnamed: IC2.17 (-IN), R9.1, R10.2
unnamed: D7.1 (A), R11.2
unnamed: D8.1 (A), R12.2
PWR: C10.1, C11.1, IC2.30 (PWR), PS4.6 (+VOUT)
PWR_COM: C10.2, C11.2, IC2.29 (PWR_COM), PS4.7 (-VOUT), R14.1
SIG_IN: IC3.6 (OUT), R1.1
V+: C2.P$1 (1), C4.2, C23.P$1 (1), D1.C, D6.C, IC1.12 (V+), R19.1, R21.1
V-: C3.P$2 (2), C5.1, C24.P$2 (2), D2.A, D5.A, IC1.10 (V-), R20.1, R22.1

Notes on the sheet:
24V to +15V
24V to +/-15V
Instrumentation Amplifier (G = -1)
24V to 10.2V
10.2V to +/- 440V
10.2V to 5V
High-voltage linear amplifier
Current-Sense Isolation Amplifier (G = 1 mV/uA)
discharge capacitor slowly when swtiched off
NTC thermistor ERT-J1VT202H (1kΩ) for inrush current protection to prevent FS10CT-12 lock-up
