mbrijbhushan/HV-amplifier/(commit log)

2021-08-02 CAM files for PCB manufacturing
    HV amplifier and HV power supply
2021-08-02 added Eagle schematic files
    [HV_amplifier_board_20210802.sch, HV_powerSupply_board_20210802.brd, HV_powerSupply_board_20210802.sch]
2022-05-28 added mounting design files
