mbrijbhushan/HV-amplifier/(notices)

Notices in the files:
parts and their libraries:
Analog Devices: COPYRIGHT: Copyright (C) 2018 Accelerated Designs. All rights reserved
